chithigun23/CustomMechanicalKeyboard/KeyboardBrief.pptx

## Keyboard brief

## Keyswitch operation

- Spring returned plastic stem pushes a leaf spring which makes contact between the two pins, seen on the right.
- “Clicky” switches have a paperclip like spring to make a sound, seen on the left

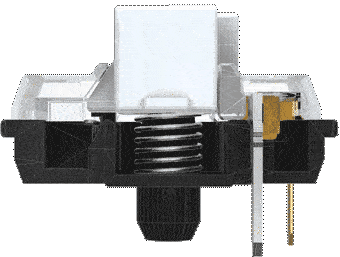
[picture p1: figure]
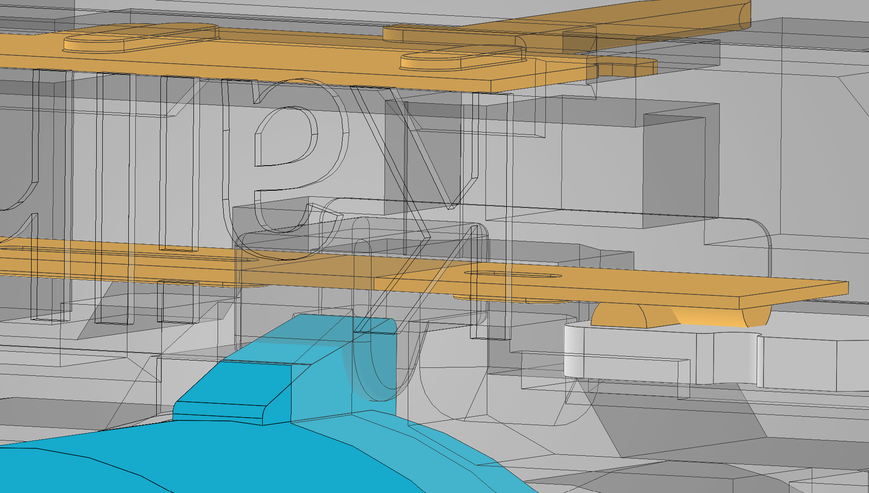
[picture p2: figure]

## Key matrix

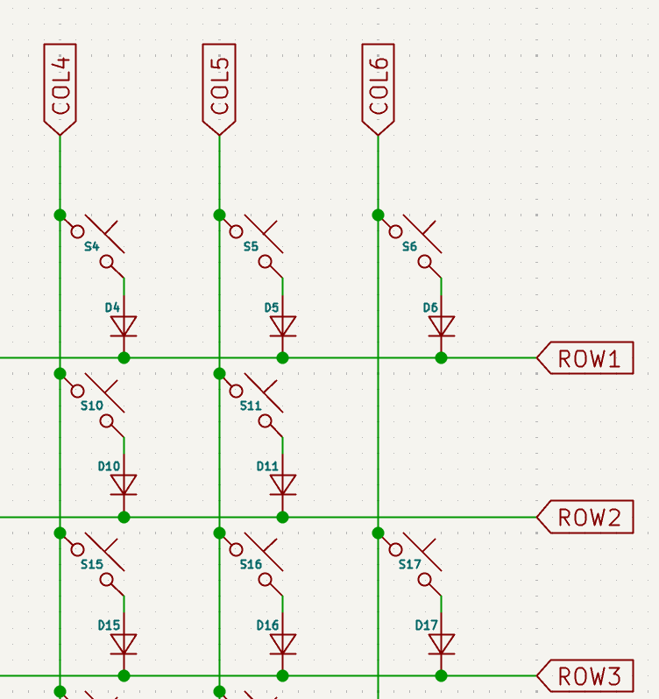
[picture p3: figure]

- Key presses utilise a matrix, like LED arrays, to reduce the GPIO pins required.
- One dimension is scanned using MCU output and another receives using MCU input.
- Diodes are used to stop ghosting, like how LED arrays ghost
- Two min video if you want (https://www.youtube.com/shorts/H4HbXRA4AxI)

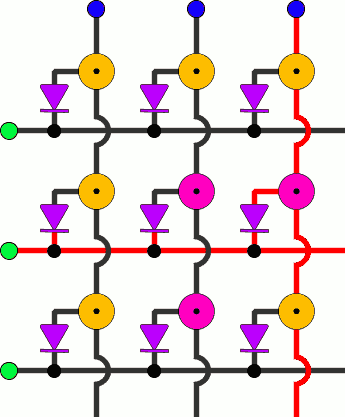
[picture p4: figure]
Building a Keyboard: Part II - Into The Matrix | The N00b Developer - A LinuxHermit's Journey

## Keyboard subsystems

- Multiple subsystems with interfacing considerations. In design order:
  1. MCU: STM32
  2. Keyswitch Array PCB
  3. Peripheral Board (Optional OLED display and volume encoder)
  4. Chassis and keycaps

## Interfacing

- Due to sizing requirements, the MCU is designed first, which will be made to fit onto keyboard PCB.
- Upgradeable MCU utilising a daughterboard
- Prioritise low profile design
- Idea is to have the MCU under the OLED display

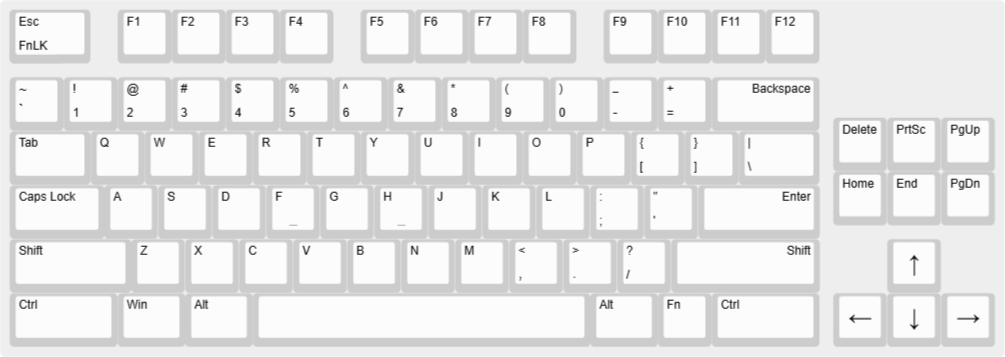
[picture p5: figure]

## Chassis

- Eventual plan for CNC Aluminium, able to create a working model using PLA or other FDM 3D printing material.
- Grounding and isolation considerations with using metal chassis
- Use of PLA sheets to electrically isolate PCB from chassis
- Star point grounding directly to MCU’s USB TVS diodes
- Mock-up on right

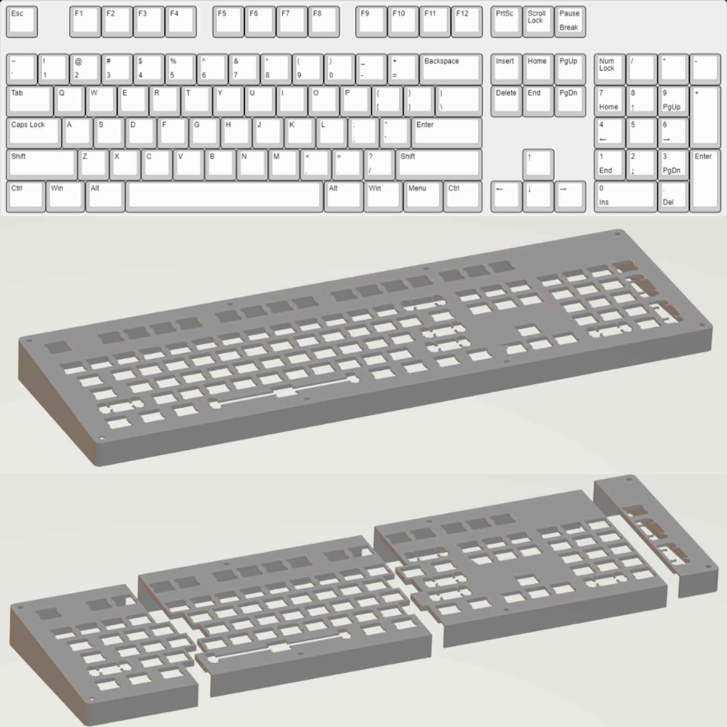
[picture p6: figure]

## Firmware

- Utilise QMK (Quantum Mechanical Keyboard) firmware
- Runs on many MCUs, preference for ARM Cortex M series
- USB consideration, some MCUs are funny with it
  - Use MCU that others have used
- Refer to QMK recommended MCU list
  - https://docs.qmk.fm/compatible_microcontrollers

## MCU

- STM32F072CBT6 (https://www.st.com/en/microcontrollers-microprocessors/stm32f072cb.html) chosen, large amount of flash and very well supported for QMK applications, more than enough GPIO, crystal-less USB 2.0.
  - Turns out a YT tutorial also chose this (https://youtu.be/o7SF2TPVV6o?si=8q0OHPD7txAeKULq)
- USB C interface, emphasis on ESD protection and signal integrity
  - Route USB as differential pairs
  - Good application specific TVS (Transient Voltage Supressing) diode chip
    - USBLC6-2 (https://www.st.com/resource/en/datasheet/usblc6-2.pdf)
- Minimised footprint

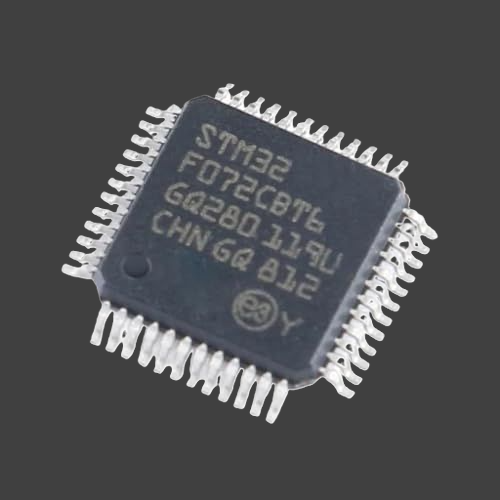
[picture p7: figure]
Stm32F072Cbt6 Stm32F072 Stm32 F072Cbt6 F072Cb Lqfp-48 Arm Cortex-M0 32-Bit Microcontroller Mcu Ic Controller Chip New for Original

## MCU So far

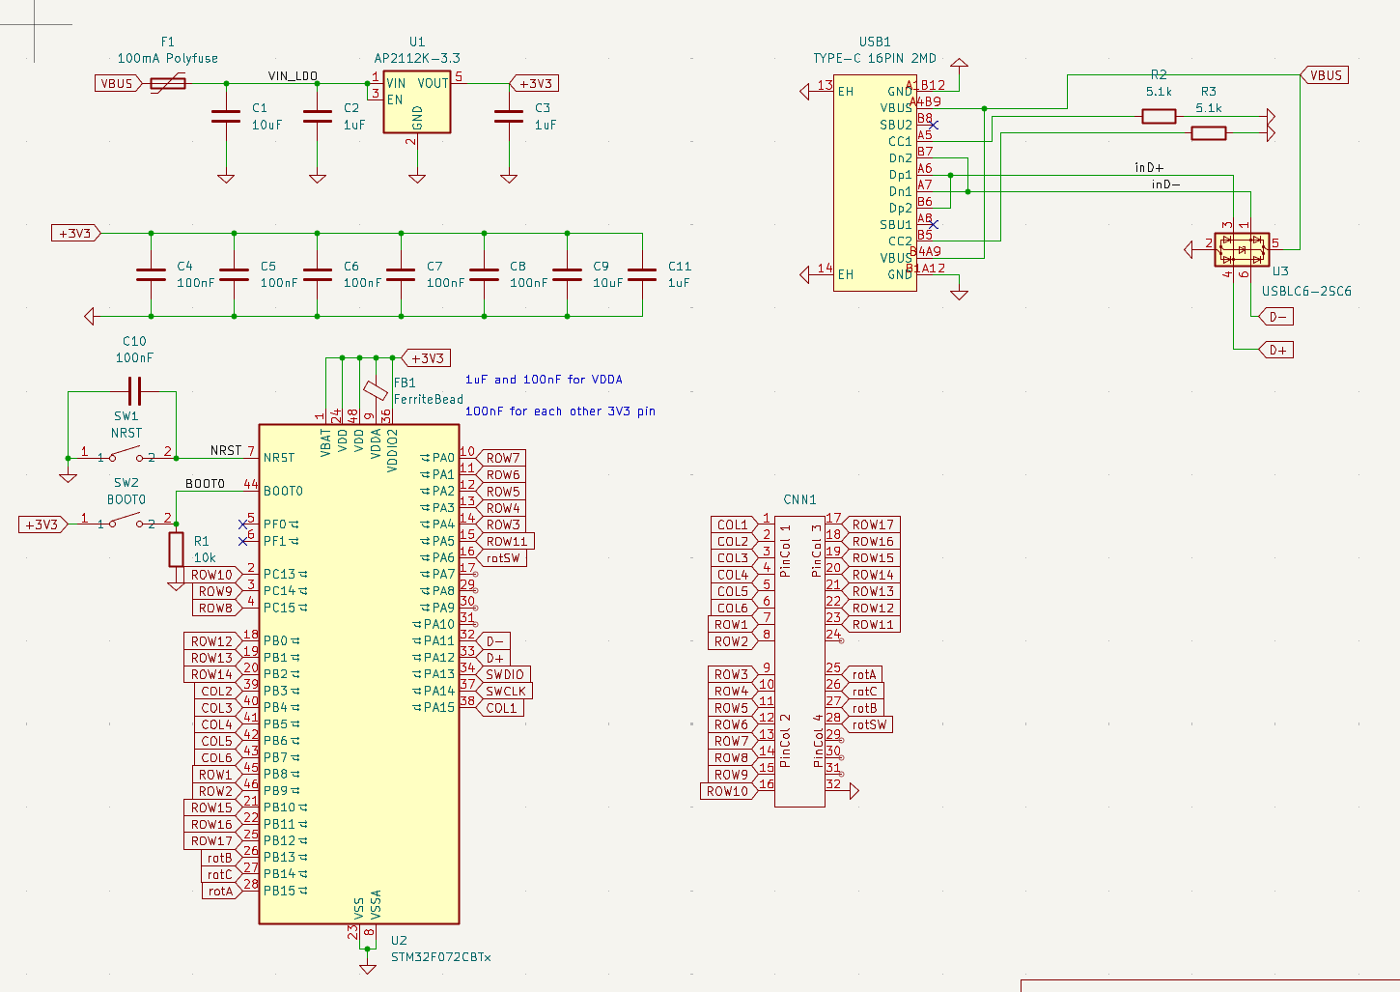
[picture p8: figure]
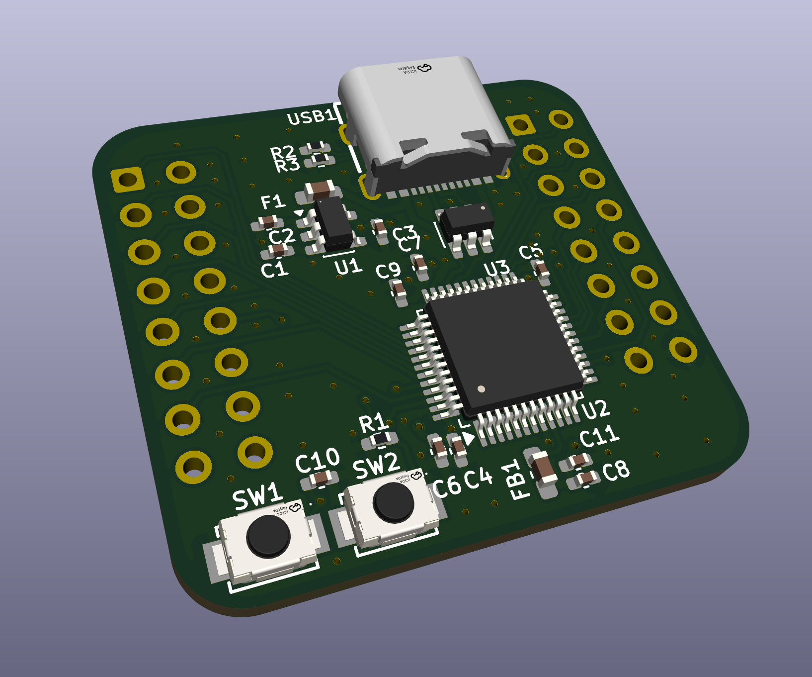
[picture p9: figure]

## Thanks
