chithigun23/CustomMechanicalKeyboard/keyMap.png

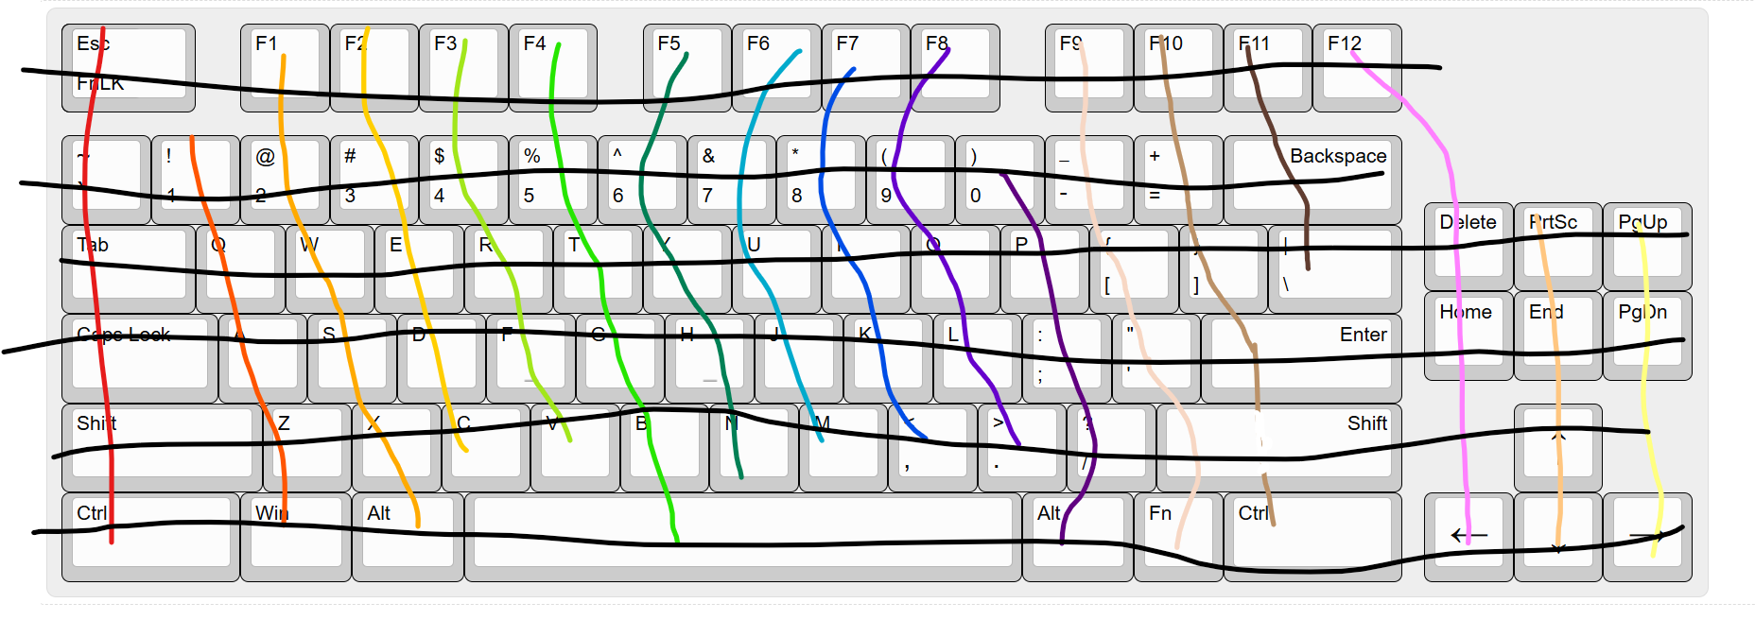
keyMap.png
