chithigun23/CustomMechanicalKeyboard/CNC Files/assembly_cnc.step

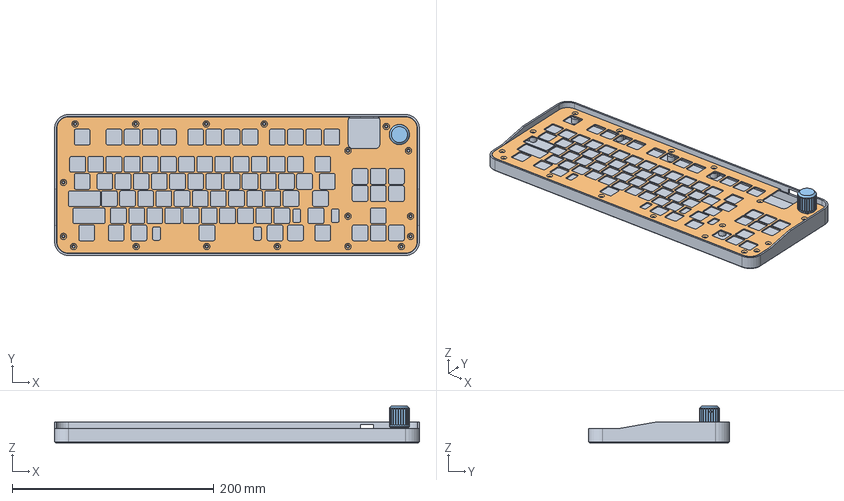
[picture p11: CAD file, 2026-09-02]
CNC Files/assembly_cnc.step
361.8 x 139.8 x 36.5 mm
