chithigun23/CustomMechanicalKeyboard/3D Print Files/keyboard_plate_flat.dxf

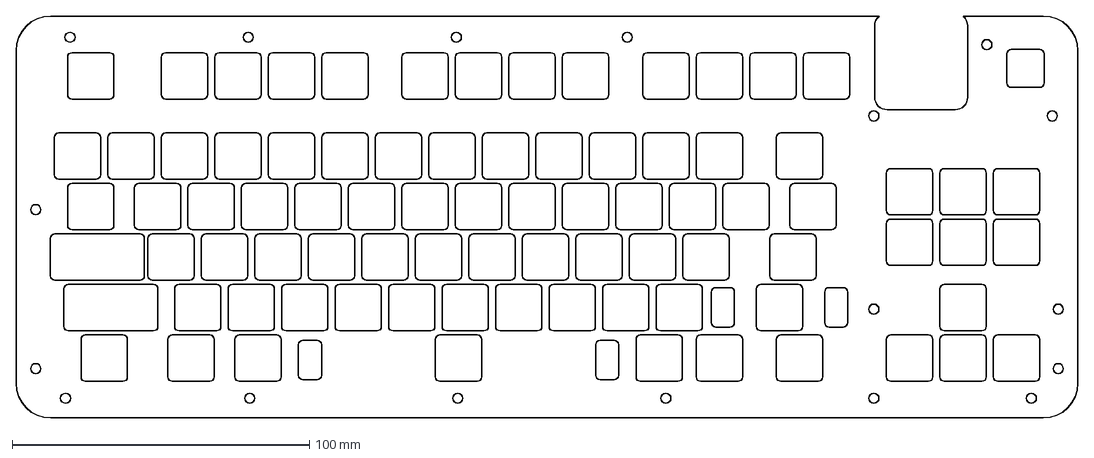
[picture p12: CAD file, 2026-09-02]
3D Print Files/keyboard_plate_flat.dxf
357.2 x 135.2 mm
