chithigun23/CustomMechanicalKeyboard/KiCAD/kbProjectLib/3d/Pins.STEP

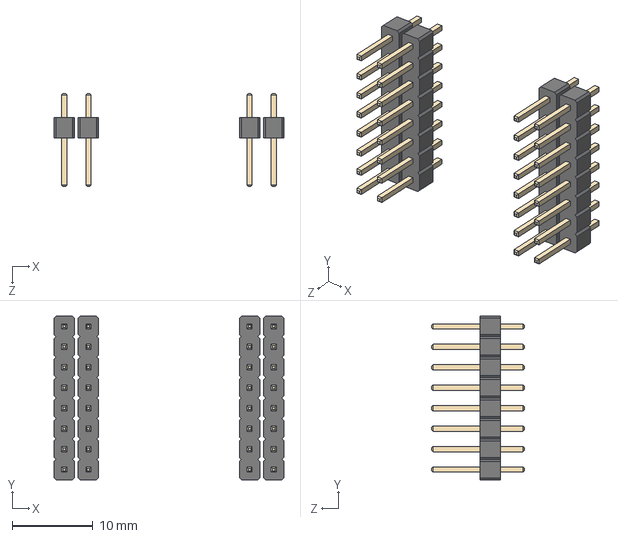
[picture p13: CAD file, 2026-08-01]
KiCAD/kbProjectLib/3d/Pins.STEP
28.5 x 20.3 x 11.5 mm
PinHeader_1x08_P2.54mm_Vertical.step x 4
