chithigun23/CustomMechanicalKeyboard/KiCAD/mcuBoard/mcu_DaughterBoard.step

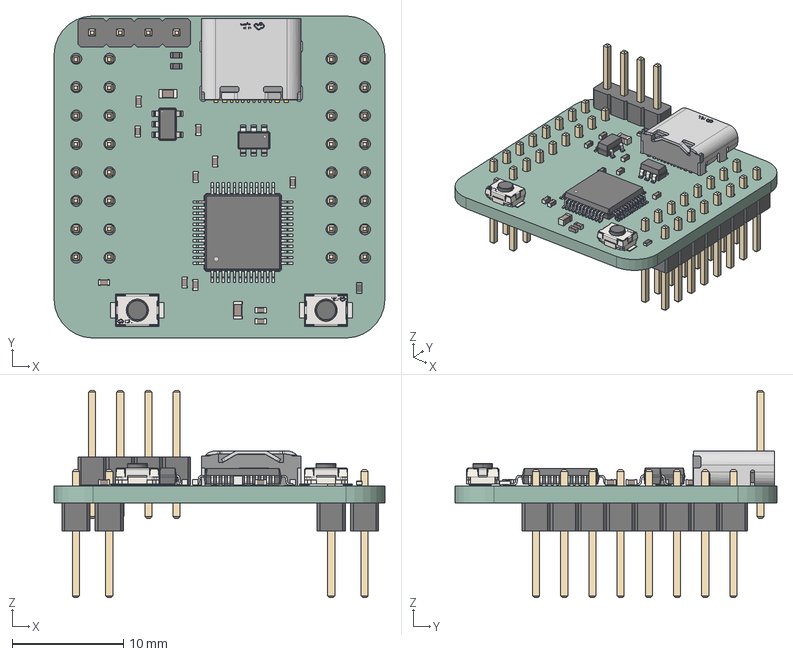
[picture p14: CAD file, 2026-09-03]
KiCAD/mcuBoard/mcu_DaughterBoard.step
29.8 x 29.0 x 18.7 mm
LQFP-48_7x7mm_P0.5mm
R_0402_1005Metric x 3
C_0603_1608Metric x 2
C_0402_1005Metric x 11
SOT-23-5
SOT-23-6
SW-SMD_L3.9-W2.9-H2.0-LS4.8 x 2
USB-C-SMD_TYPE-C-6PIN-2MD-073
PinHeader_1x04_P254mm_Vertical
PinHeader_1x08_P2.54mm_Vertical.step x 4
mcu_DaughterBoard_PCB
