chithigun23/CustomMechanicalKeyboard/stencil_front.3mf

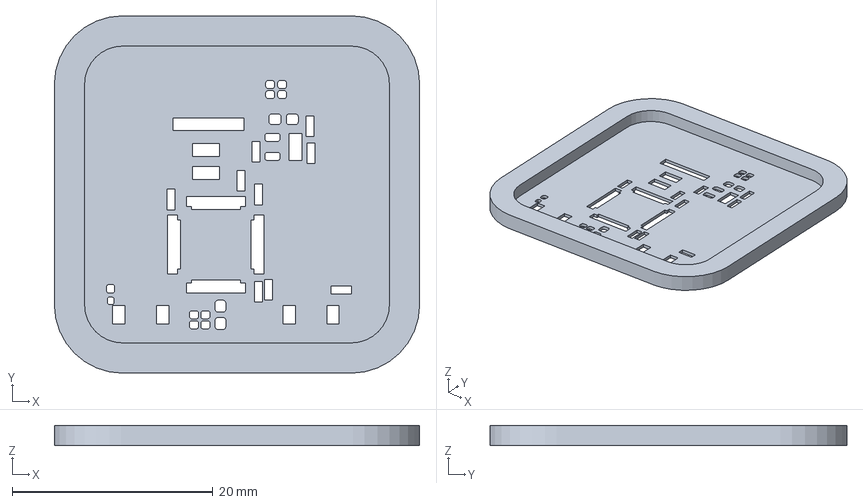
[picture p15: CAD file, 2026-08-24]
stencil_front.3mf
36.4 x 35.6 x 2.00 mm
