chithigun23/CustomMechanicalKeyboard/CNC Files/keyboard_plate.step

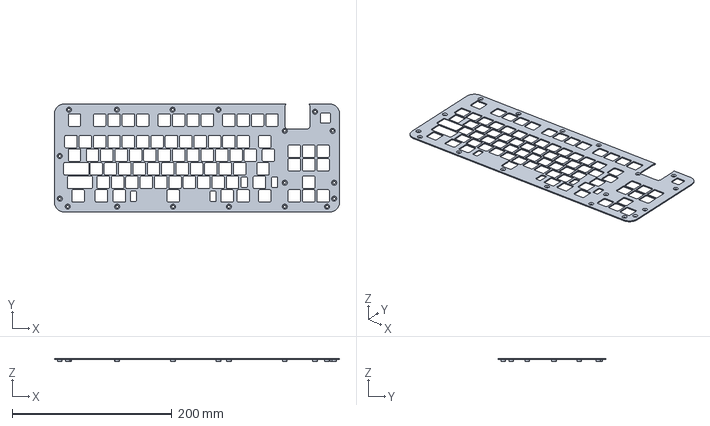
[picture p16: CAD file, 2026-09-02]
CNC Files/keyboard_plate.step
357.2 x 135.2 x 3.60 mm
