chithigun23/CustomMechanicalKeyboard/KiCAD/kbProjectLib/3d/Stabilizer_Cherry_MX_6.25u.stp

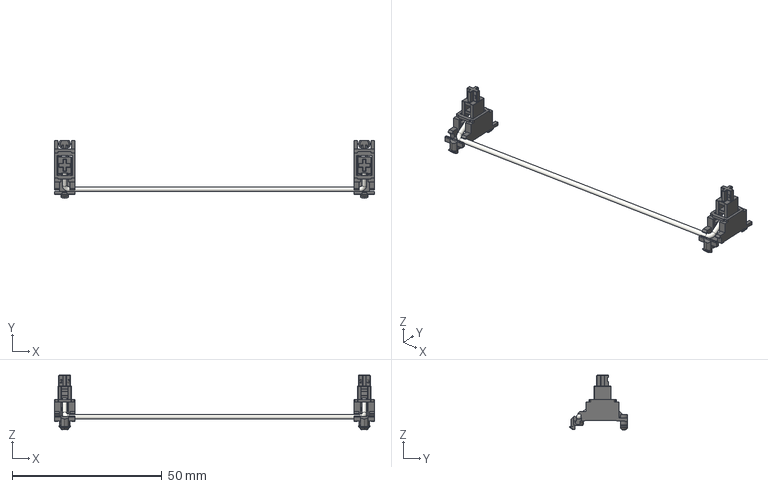
[picture p17: CAD file, 2026-08-01]
KiCAD/kbProjectLib/3d/Stabilizer_Cherry_MX_6.25u.stp
106.8 x 19.2 x 18.3 mm
