chithigun23/CustomMechanicalKeyboard/CNC Files/keyboard_case_cnc_tapped.step

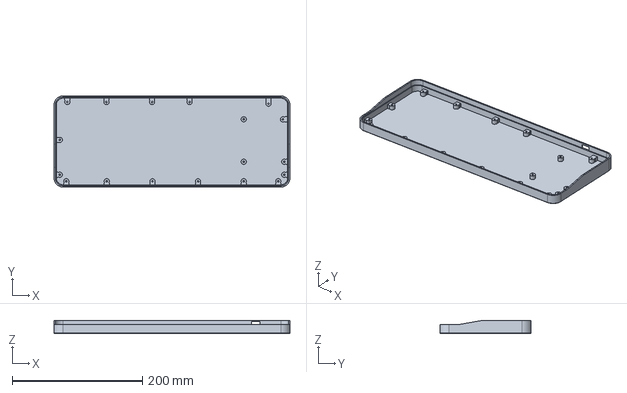
[picture p18: CAD file, 2026-09-02]
CNC Files/keyboard_case_cnc_tapped.step
361.8 x 139.8 x 20.5 mm
