chithigun23/CustomMechanicalKeyboard/KiCAD/kbProjectLib/3d/Stabilizer_Cherry_MX_2.00u.stp

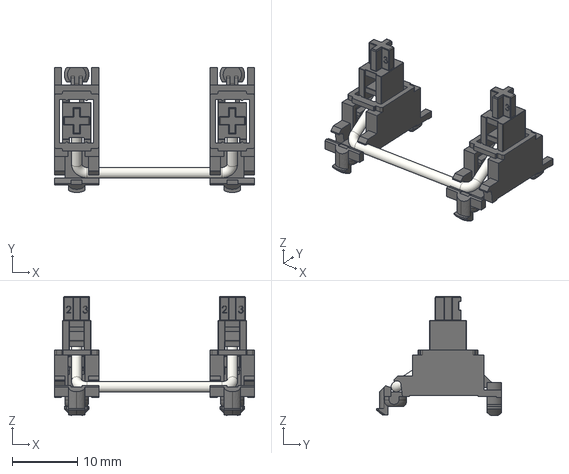
[picture p19: CAD file, 2026-08-01]
KiCAD/kbProjectLib/3d/Stabilizer_Cherry_MX_2.00u.stp
30.7 x 19.2 x 18.3 mm
