chithigun23/CustomMechanicalKeyboard/3D Print Files/encoder_knob_D_shaft.step

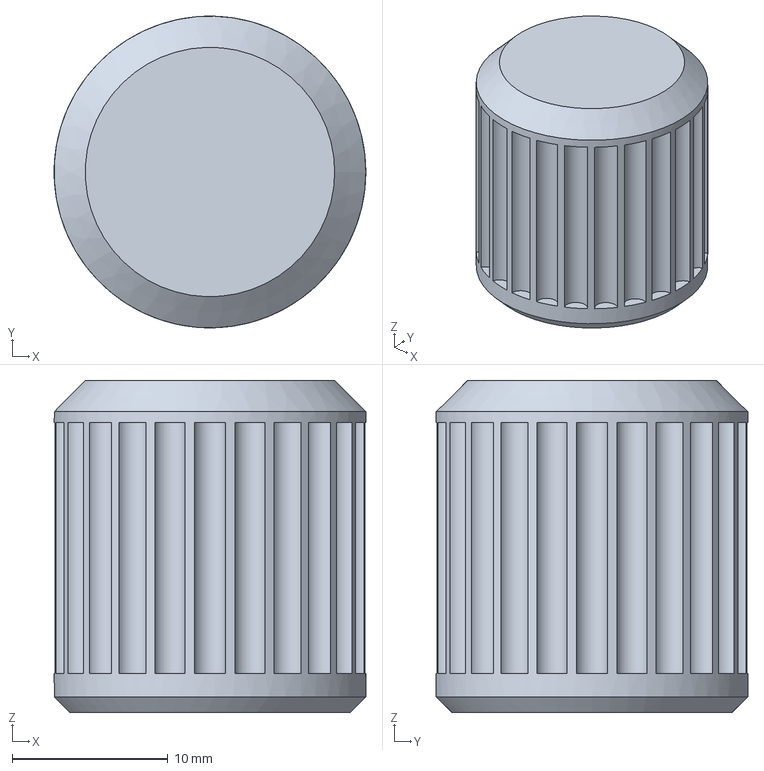
[picture p20: CAD file, 2026-09-02]
3D Print Files/encoder_knob_D_shaft.step
20.0 x 20.0 x 21.3 mm
