chithigun23/CustomMechanicalKeyboard/3D Print Files/keyboard_case.step

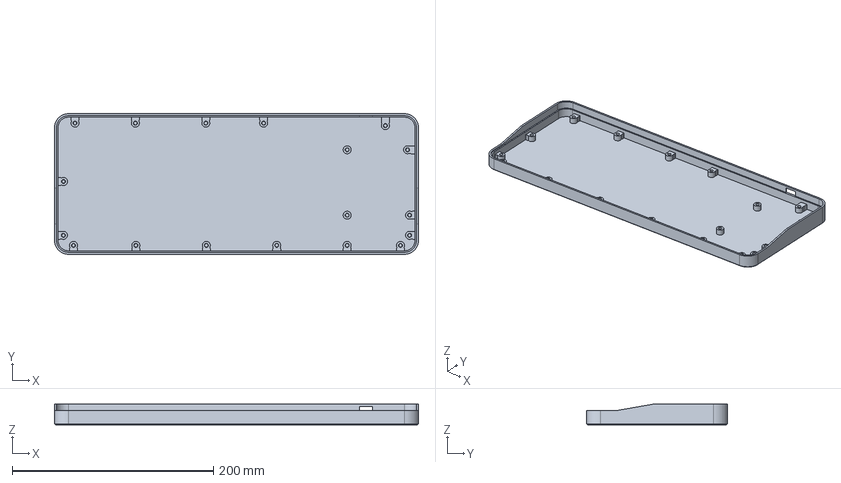
[picture p22: CAD file, 2026-09-02]
3D Print Files/keyboard_case.step
361.8 x 139.8 x 20.5 mm
