chithigun23/CustomMechanicalKeyboard/KiCAD/kbProjectLib/3d/blue.step

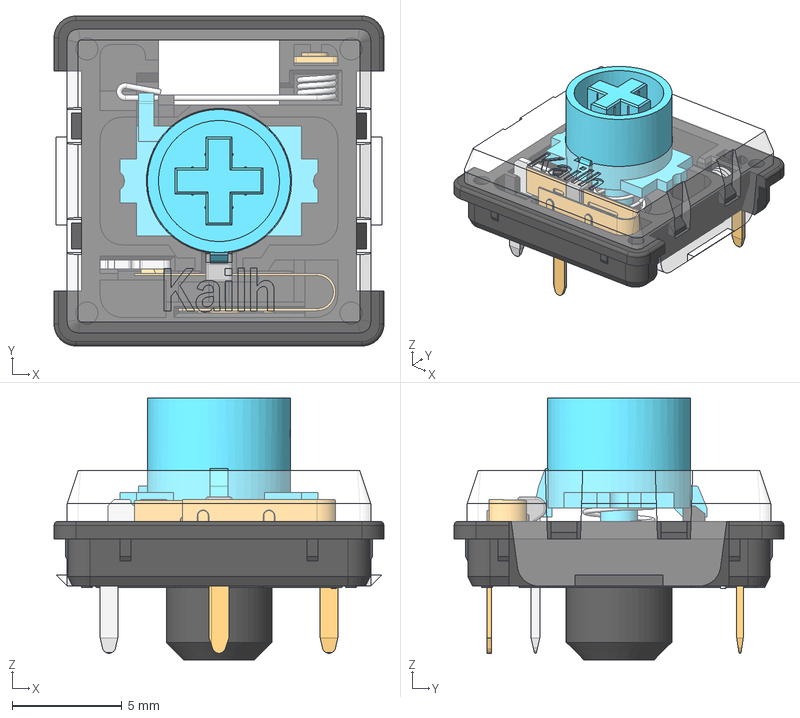
[picture p23: CAD file, 2026-07-26]
KiCAD/kbProjectLib/3d/blue.step
15.0 x 15.0 x 11.9 mm
bottom
contact
pin1
stem
top
pin2
pin3
click_bar
shrunken_spring
