chithigun23/CustomMechanicalKeyboard/CNC Files/encoder_knob_cnc_grubscrew.step

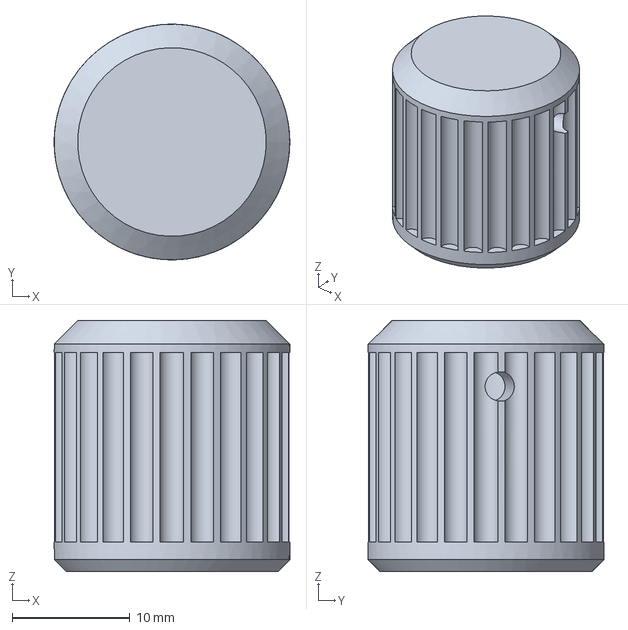
[picture p24: CAD file, 2026-09-02]
CNC Files/encoder_knob_cnc_grubscrew.step
20.0 x 20.0 x 21.3 mm
