chithigun23/CustomMechanicalKeyboard/(list of files, cad)

Other CAD files:
3D Print Files/assembly_print.step
3D Print Files/encoder_knob_D_shaft.stl
3D Print Files/keyboard_case.stl
3D Print Files/keyboard_plate.stl
stencil_front.stl
