chithigun23/CustomMechanicalKeyboard/KiCAD/keyBoard/keyboardKiCad.kicad_pcb

## KiCad design KiCAD/keyBoard/keyboardKiCad.kicad_pcb (2026-09-03)

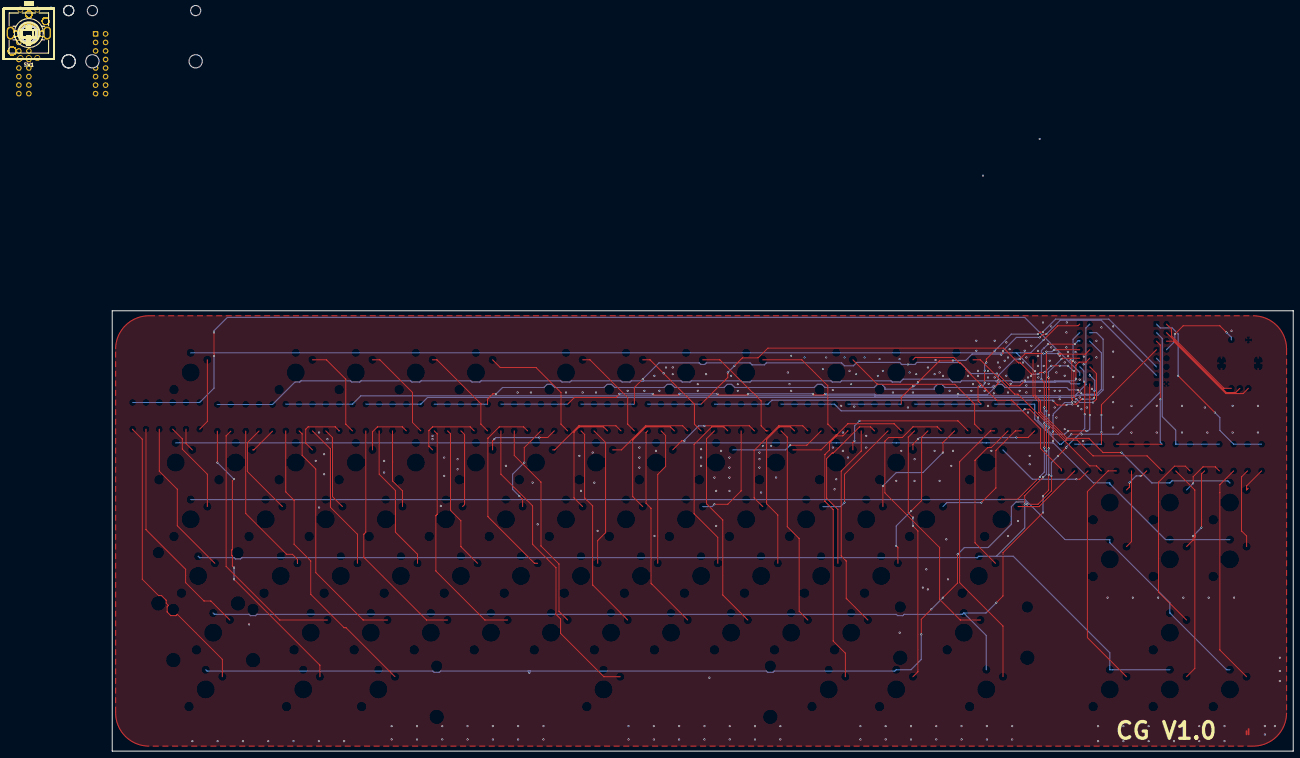
[picture p25: board keyboardKiCad.kicad_pcb from above]

Board: 2 copper layers, 354.0 x 132.0 mm, 172 parts (0 on the bottom side), 111 nets.

Parts:
CNN1: keyboardMCU_Connector
D1, D2, D3, D4, D5, D6, D7, D8, D9, D10, D11, D12, D13, D14, D15, D16, D17, D18, D19, D20, D21, D22, D23, D24, D25, D26, D27, D28, D29, D30, D31, D32, D33, D34, D35, D36, D37, D38, D39, D40, D41, D42, D43, D44, D45, D46, D47, D48, D49, D50, D51, D52, D53, D54, D55, D56, D57, D58, D59, D60, D61, D62, D63, D64, D66, D67, D68, D69, D70, D71, D72, D73, D74, D75, D76, D77, D78, D79, D80, D81, D82, D83, D84: DO-35_BD2.0-L4.0-P8.00-D0.5-FD
H1, H4: Stabilizer_Cherry_MX_2.00u
H7: Stabilizer_Cherry_MX_3.00u
H8: Stabilizer_Cherry_MX_6.25u
S1, S3, S72: SW_Kailh_Choc_V2_1.50u
S2, S7, S8, S9, S10, S12, S13, S14, S15, S16, S18, S19, S20, S21, S22, S23, S24, S25, S26, S27, S28, S29, S30, S31, S32, S34, S35, S36, S37, S38, S39, S40, S41, S42, S43, S44, S45, S46, S47, S48, S49, S50, S51, S52, S53, S54, S55, S56, S57, S59, S60, S61, S62, S64, S65, S66, S67, S70, S73, S74, S75, S76, S77, S78, S79, S80, S81, S82, S83: SW_Kailh_Choc_V2_1.00u
S4: SW_Kailh_Choc_V2_1.75u
S5, S68: SW_Kailh_Choc_V2_2.25u
S6, S69, S71: SW_Kailh_Choc_V2_2.00u
S11, S17, S58: SW_Kailh_Choc_V2_1.25u
S33: SW_Kailh_Choc_V2_6.25u
S63: SW_Kailh_Choc_V2_2.75u
SW1: RotaryEncoder_Switch_MP; SW-TH_EC11XXXXXXXX

Connections:
COL1: CNN1.7, D1.1 (K), D2.1 (K), D3.1 (K), D4.1 (K), D5.1 (K), D6.1 (K)
COL2: CNN1.8, D7.1 (K), D8.1 (K), D9.1 (K), D10.1 (K), D11.1 (K)
COL3: CNN1.9, D12.1 (K), D13.1 (K), D14.1 (K), D15.1 (K), D16.1 (K), D17.1 (K)
COL4: CNN1.10, D18.1 (K), D19.1 (K), D20.1 (K), D21.1 (K), D22.1 (K)
COL5: CNN1.11, D23.1 (K), D24.1 (K), D25.1 (K), D26.1 (K), D27.1 (K)
COL6: CNN1.12, D28.1 (K), D29.1 (K), D30.1 (K), D31.1 (K), D32.1 (K), D33.1 (K)
COL7: CNN1.13, D34.1 (K), D35.1 (K), D36.1 (K), D37.1 (K), D38.1 (K)
COL8: CNN1.14, D39.1 (K), D40.1 (K), D41.1 (K), D42.1 (K), D43.1 (K)
COL9: CNN1.15, D44.1 (K), D45.1 (K), D46.1 (K), D47.1 (K), D48.1 (K)
COL10: CNN1.16, D49.1 (K), D50.1 (K), D51.1 (K), D52.1 (K), D53.1 (K)
COL11: CNN1.23, D54.1 (K), D55.1 (K), D56.1 (K), D57.1 (K), D58.1 (K)
COL12: CNN1.22, D59.1 (K), D60.1 (K), D61.1 (K), D62.1 (K), D63.1 (K), D64.1 (K)
COL13: CNN1.21, D66.1 (K), D67.1 (K), D68.1 (K), D69.1 (K), D70.1 (K)
COL14: CNN1.20, D71.1 (K), D72.1 (K), D73.1 (K)
COL15: CNN1.19, D74.1 (K), D75.1 (K), D76.1 (K), D77.1 (K)
COL16: CNN1.18, D78.1 (K), D79.1 (K), D80.1 (K), D81.1 (K)
COL17: CNN1.17, D82.1 (K), D83.1 (K), D84.1 (K)
GND: CNN1.32, SW1.6, SW1.7, SW1.E
unnamed: D1.2 (A), S1.2
unnamed: D2.2 (A), S2.2
unnamed: D3.2 (A), S3.2
unnamed: D4.2 (A), S4.2
unnamed: D5.2 (A), S5.2
unnamed: D6.2 (A), S6.2
unnamed: D7.2 (A), S7.2
unnamed: D8.2 (A), S8.2
unnamed: D9.2 (A), S9.2
unnamed: D10.2 (A), S10.2
unnamed: D11.2 (A), S11.2
unnamed: D12.2 (A), S12.2
unnamed: D13.2 (A), S13.2
unnamed: D14.2 (A), S14.2
unnamed: D15.2 (A), S15.2
unnamed: D16.2 (A), S16.2
unnamed: D17.2 (A), S17.2
unnamed: D18.2 (A), S18.2
unnamed: D19.2 (A), S19.2
unnamed: D20.2 (A), S20.2
unnamed: D21.2 (A), S21.2
unnamed: D22.2 (A), S22.2
unnamed: D23.2 (A), S23.2
unnamed: D24.2 (A), S24.2
unnamed: D25.2 (A), S25.2
unnamed: D26.2 (A), S26.2
unnamed: D27.2 (A), S27.2
unnamed: D28.2 (A), S28.2
unnamed: D29.2 (A), S29.2
unnamed: D30.2 (A), S30.2
unnamed: D31.2 (A), S31.2
unnamed: D32.2 (A), S32.2
unnamed: D33.2 (A), S33.2
unnamed: D34.2 (A), S34.2
unnamed: D35.2 (A), S35.2
unnamed: D36.2 (A), S36.2
unnamed: D37.2 (A), S37.2
unnamed: D38.2 (A), S38.2
unnamed: D39.2 (A), S39.2
unnamed: D40.2 (A), S40.2
unnamed: D41.2 (A), S41.2
unnamed: D42.2 (A), S42.2
unnamed: D43.2 (A), S43.2
unnamed: D44.2 (A), S44.2
unnamed: D45.2 (A), S45.2
unnamed: D46.2 (A), S46.2
unnamed: D47.2 (A), S47.2
unnamed: D48.2 (A), S48.2
unnamed: D49.2 (A), S49.2
unnamed: D50.2 (A), S50.2
unnamed: D51.2 (A), S51.2
unnamed: D52.2 (A), S52.2
unnamed: D53.2 (A), S53.2
unnamed: D54.2 (A), S54.2
unnamed: D55.2 (A), S55.2
unnamed: D56.2 (A), S56.2
unnamed: D57.2 (A), S57.2
unnamed: D58.2 (A), S58.2
unnamed: D59.2 (A), S59.2
unnamed: D60.2 (A), S60.2
unnamed: D61.2 (A), S61.2
unnamed: D62.2 (A), S62.2
unnamed: D63.2 (A), S63.2
unnamed: D64.2 (A), S64.2
unnamed: D66.2 (A), S65.2
unnamed: D67.2 (A), S66.2
unnamed: D68.2 (A), S67.2
unnamed: D69.2 (A), S68.2
unnamed: D70.2 (A), S69.2
unnamed: D71.2 (A), S70.2
unnamed: D72.2 (A), S71.2
unnamed: D73.2 (A), S72.2
unnamed: D74.2 (A), S73.2
unnamed: D75.2 (A), S74.2
unnamed: D76.2 (A), S75.2
unnamed: D77.2 (A), S76.2
unnamed: D78.2 (A), S77.2
unnamed: D79.2 (A), S78.2
unnamed: D80.2 (A), S79.2
unnamed: D81.2 (A), S80.2
unnamed: D82.2 (A), S81.2
unnamed: D83.2 (A), S82.2
unnamed: D84.2 (A), S83.2
ROW1: CNN1.1, S1.1, S12.1, S18.1, S23.1, S28.1, S34.1, S39.1, S44.1, S49.1, S59.1, S65.1, S70.1, S73.1, S77.1, S81.1
ROW2: CNN1.2, S2.1, S7.1, S13.1, S19.1, S24.1, S29.1, S35.1, S40.1, S45.1, S50.1, S54.1, S60.1, S66.1, S71.1, S74.1, S78.1, S82.1
ROW3: CNN1.3, S3.1, S8.1, S14.1, S20.1, S25.1, S30.1, S36.1, S41.1, S46.1, S51.1, S55.1, S61.1, S67.1, S72.1, S75.1, S79.1, S83.1
ROW4: CNN1.4, S4.1, S9.1, S15.1, S21.1, S26.1, S31.1, S37.1, S42.1, S47.1, S52.1, S56.1, S62.1, S68.1, S76.1, S80.1
ROW5: CNN1.5, S5.1, S10.1, S16.1, S22.1, S27.1, S32.1, S38.1, S43.1, S48.1, S53.1, S57.1, S63.1, S69.1
ROW6: CNN1.6, S6.1, S11.1, S17.1, S33.1, S58.1, S64.1
rotA: CNN1.25, SW1.A
rotB: CNN1.27, SW1.B
rotC: CNN1.26, SW1.C
rotSW: CNN1.28, SW1.D
