chithigun23/CustomMechanicalKeyboard/KiCAD/mcuBoard/mcu_DaughterBoard.kicad_pcb

## KiCad design KiCAD/mcuBoard/mcu_DaughterBoard.kicad_pcb (2026-08-10)

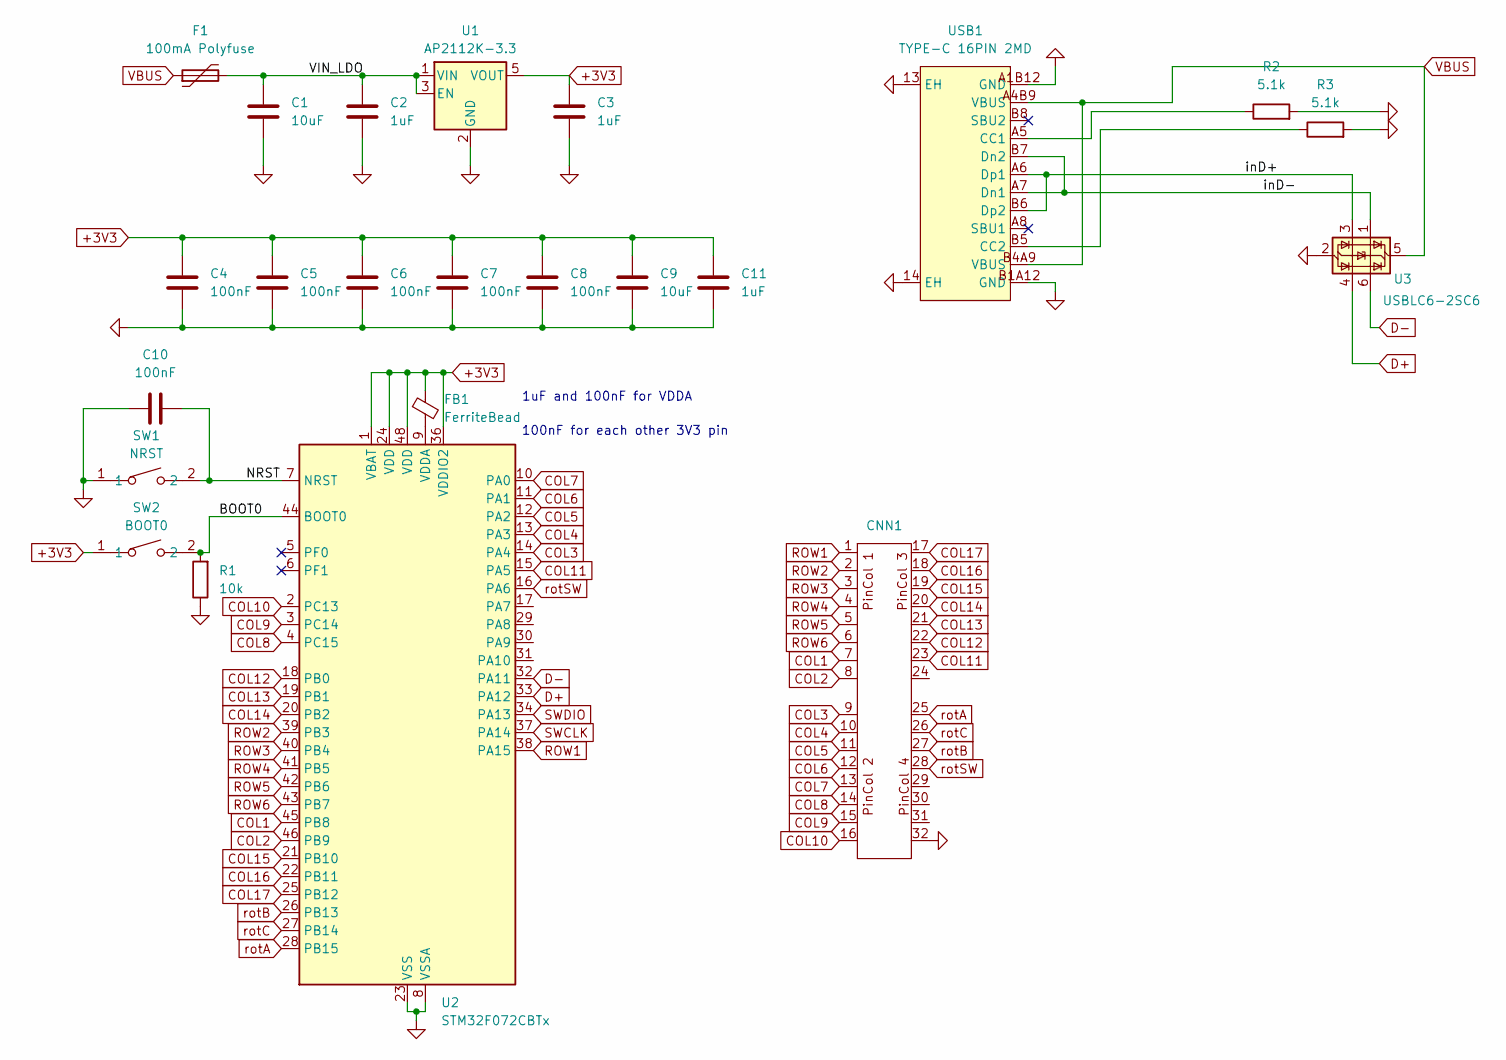
[picture p26: schematic mcu_DaughterBoard.kicad_sch]

Parts:
C1, C9: 10uF; C_0402_1005Metric_Pad0.74x0.62mm_HandSolder
C2, C3, C11: 1uF; C_0402_1005Metric_Pad0.74x0.62mm_HandSolder
C4, C5, C6, C7, C8, C10: 100nF; C_0402_1005Metric_Pad0.74x0.62mm_HandSolder
CNN1: keyboardMCU_Connector
F1: 100mA Polyfuse; C_0603_1608Metric_Pad1.08x0.95mm_HandSolder
FB1: FerriteBead; C_0603_1608Metric_Pad1.08x0.95mm_HandSolder
R1: 10k; R_0402_1005Metric_Pad0.72x0.64mm_HandSolder
R2, R3: 5.1k; R_0402_1005Metric_Pad0.72x0.64mm_HandSolder
SW1: NRST; SW-SMD_L3.9-W3.0-P4.45; MPN TS-1088-AR02016; LCSC Part C720477
SW2: BOOT0; SW-SMD_L3.9-W3.0-P4.45; MPN TS-1088-AR02016; LCSC Part C720477
U1: AP2112K-3.3; SOT-23-5
U2: STM32F072CBTx; LQFP-48_7x7mm_P0.5mm
U3: USBLC6-2SC6; SOT-23-6
USB1: TYPE-C 16PIN 2MD; USB-C-SMD_TYPE-C-16PIN-2MD-073; MPN TYPE-C 16PIN 2MD(073); LCSC Part C2765186

Connections:
+3V3: C3.1, C4.2, C5.2, C6.2, C7.2, C8.2, C9.2, C11.1, FB1.1, SW2.1, U1.5 (VOUT), U2.1 (VBAT), U2.24 (VDD), U2.36 (VDDIO2), U2.48 (VDD); also elsewhere on the board
/BOOT0: R1.2, SW2.2, U2.44 (BOOT0)
/NRST: C10.2, SW1.2, U2.7 (NRST)
/VIN_LDO: C1.2, C2.1, F1.2, U1.1 (VIN), U1.3 (EN)
/inD+: U3.3 (I/O2), USB1.A6 (Dp1), USB1.B6 (Dp2)
/inD-: U3.1 (I/O1), USB1.A7 (Dn1), USB1.B7 (Dn2)
COL1: CNN1.7, U2.45 (PB8)
COL2: CNN1.8, U2.46 (PB9)
COL3: CNN1.9, U2.14 (PA4)
COL4: CNN1.10, U2.13 (PA3)
COL5: CNN1.11, U2.12 (PA2)
COL6: CNN1.12, U2.11 (PA1)
COL7: CNN1.13, U2.10 (PA0)
COL8: CNN1.14, U2.4 (PC15)
COL9: CNN1.15, U2.3 (PC14)
COL10: CNN1.16, U2.2 (PC13)
COL11: CNN1.23, U2.15 (PA5)
COL12: CNN1.22, U2.18 (PB0)
COL13: CNN1.21, U2.19 (PB1)
COL14: CNN1.20, U2.20 (PB2)
COL15: CNN1.19, U2.21 (PB10)
COL16: CNN1.18, U2.22 (PB11)
COL17: CNN1.17, U2.25 (PB12)
D+: U2.33 (PA12), U3.4 (I/O2)
D-: U2.32 (PA11), U3.6 (I/O1)
GND: C1.1, C2.2, C3.2, C4.1, C5.1, C6.1, C7.1, C8.1, C9.1, C10.1, C11.2, CNN1.32, R1.1, R2.2, R3.2, SW1.1, U1.2 (GND), U2.8 (VSSA), U2.23 (VSS), U2.35 (VSS), U2.47 (VSS), U3.2 (GND), USB1.13 (EH), USB1.14 (EH), USB1.A1B12 (GND), USB1.B1A12 (GND); also elsewhere on the board
unnamed: FB1.2, U2.9 (VDDA)
unnamed: R2.1, USB1.A5 (CC1)
unnamed: R3.1, USB1.B5 (CC2)
ROW1: CNN1.1, U2.38 (PA15)
ROW2: CNN1.2, U2.39 (PB3)
ROW3: CNN1.3, U2.40 (PB4)
ROW4: CNN1.4, U2.41 (PB5)
ROW5: CNN1.5, U2.42 (PB6)
ROW6: CNN1.6, U2.43 (PB7)
SWCLK: U2.37 (PA14); also elsewhere on the board
SWDIO: U2.34 (PA13); also elsewhere on the board
VBUS: F1.1, U3.5 (VBUS), USB1.A4B9 (VBUS), USB1.B4A9 (VBUS)
rotA: CNN1.25, U2.28 (PB15)
rotB: CNN1.27, U2.26 (PB13)
rotC: CNN1.26, U2.27 (PB14)
rotSW: CNN1.28, U2.16 (PA6)

Notes on the sheet:
1uF and 100nF for VDDA
100nF for each other 3V3 pin

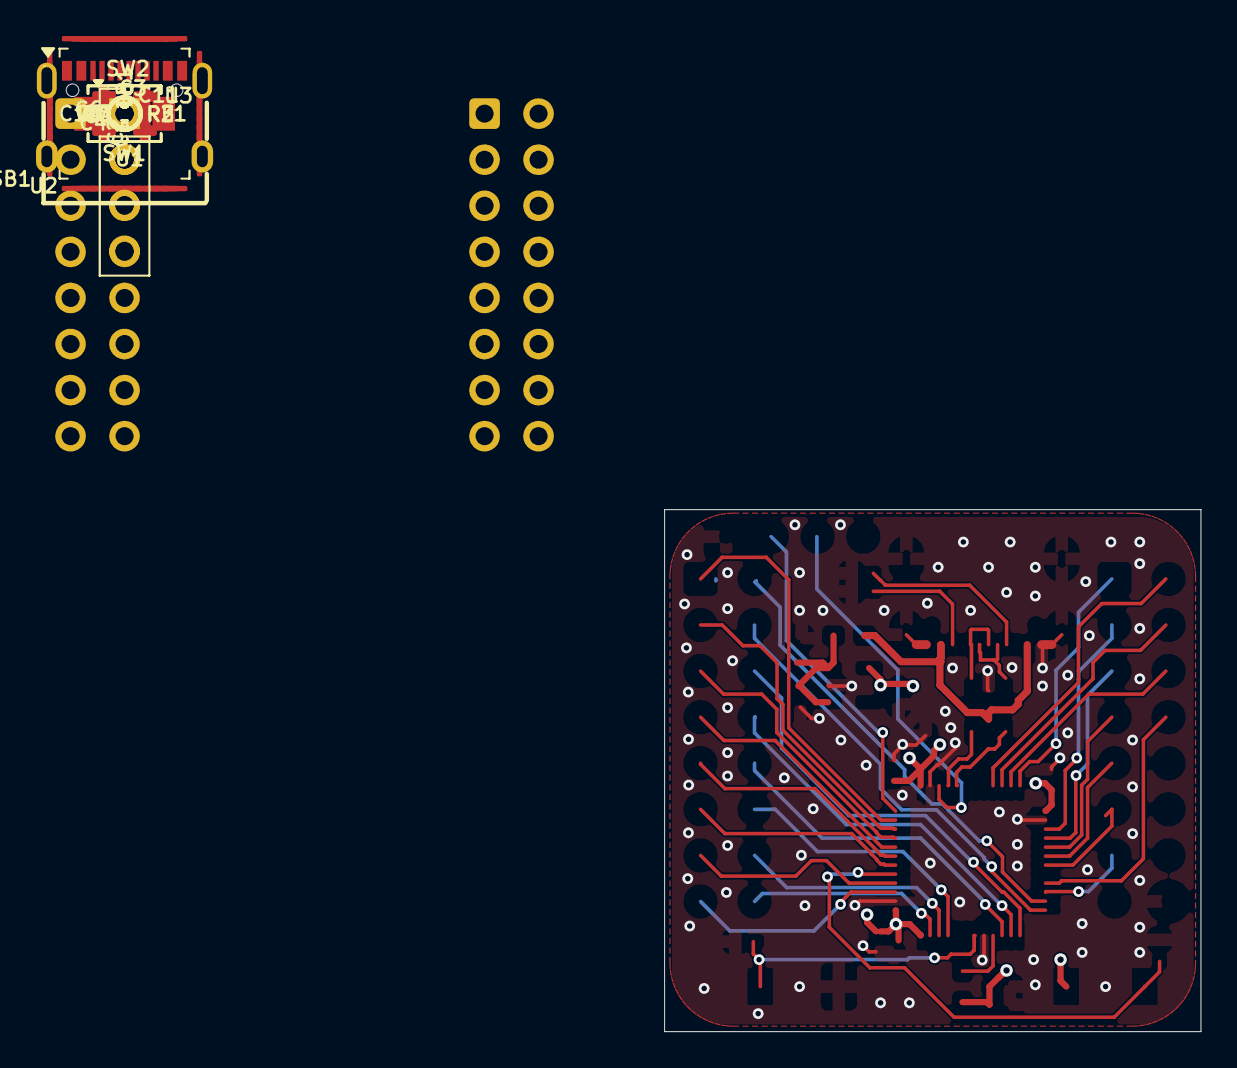
[picture p27: board mcu_DaughterBoard.kicad_pcb from above]

Board: 4 copper layers, 29.8 x 29.0 mm, 24 parts (0 on the bottom side), 42 nets.

Other parts of the board:
J1: Conn_SWD; PinHeader_1x04_P2.54mm_Vertical

Their connections:
+3V3: J1.4; also elsewhere on the board
GND: J1.1; also elsewhere on the board
SWCLK: J1.2; also elsewhere on the board
SWDIO: J1.3; also elsewhere on the board
