chithigun23/CustomMechanicalKeyboard/(commit log)

2026-07-26 Rebuild repo without invalid Windows paths, issue with Linux filepaths
    [blue.step, keyboardKiCad.kicad_pcb, keyboardKiCad.kicad_sch, mcu_DaughterBoard.kicad_pcb, mcu_DaughterBoard.kicad_sch, mcu_DaughterBoard.step]
2026-07-26 Fixed net names, columns and rows were switched.
    [mcu_DaughterBoard.kicad_pcb, mcu_DaughterBoard.kicad_sch]
2026-08-01 Fixed dimentions of the keyboard PCB, need to update 3D models
    [keyboardKiCad.kicad_pcb]
2026-08-01 Keyboard routing initially complete
    [blue.step, keyboardKiCad.kicad_pcb, keyboardKiCad.kicad_sch]
2026-08-01 saving before running 3d file fixing script
    [Stabilizer_Cherry_MX_2.00u.stp, Stabilizer_Cherry_MX_3.00u.stp, Stabilizer_Cherry_MX_6.25u.stp, keyboardKiCad.kicad_pcb, keyboardKiCad.kicad_sch]
2026-08-01 MCU board has been mounted on to the keyboard PCB. Need to check if spacing is appropriate irl using calipers. Then do mounting holes using star point grounding due to use with metal chassis. ie sepe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
    [Pins.STEP, keyboardKiCad.kicad_pcb, keyboardKiCad.kicad_sch, mcu_DaughterBoard.kicad_pcb, mcu_DaughterBoard.step]
2026-08-01 Finished routing, including chassis grounding. One thing, I might need SWD for the MCU. QMK should be able to use USB though. Need to check this.
    [keyboardKiCad.kicad_pcb, keyboardKiCad.kicad_sch]
2026-08-07 Added SWD connector headers. Touched up routing on both boards.
    [keyboardKiCad.kicad_pcb, mcu_DaughterBoard.kicad_pcb, mcu_DaughterBoard.kicad_sch]
2026-08-09 Gerber files generated, small touch ups to pass DRC. Ready for purchase.
    [keyboardKiCad.kicad_pcb, mcu_DaughterBoard.kicad_pcb]
2026-08-10 Removed star point grounding on Hector's advice.
    [keyboardKiCad.kicad_pcb]
2026-08-10 Added silly logo, regenerated gerber
    [keyboardKiCad.kicad_pcb, mcu_DaughterBoard.kicad_pcb]
2026-08-24 Added extra files
    [Pins.STEP, Stabilizer_Cherry_MX_2.00u.stp, Stabilizer_Cherry_MX_3.00u.stp, Stabilizer_Cherry_MX_6.25u.stp, blue.step, keyboardKiCad.kicad_sch, mcu_DaughterBoard.kicad_sch, mcu_DaughterBoard.step]
2026-08-24 Stencil added
    Committer: chithi <chithigun23@gmail.com>
    [stencil_front.stl]
2026-08-24 Added 3mf file
    [stencil_front.3mf]
2026-08-25 Restored kbProjectLib, schematics and fp-lib-table accidentally deleted in 995ade5
    [Pins.STEP, Stabilizer_Cherry_MX_2.00u.stp, Stabilizer_Cherry_MX_3.00u.stp, Stabilizer_Cherry_MX_6.25u.stp, blue.step, keyboardKiCad.kicad_sch, mcu_DaughterBoard.kicad_sch]
2026-09-02 Created files for CNC manufacture of case. Begun creating renders
    [assembly_cnc.step, assembly_print.step, encoder_knob_D_shaft.step, encoder_knob_D_shaft.stl, encoder_knob_cnc_grubscrew.step, keyboard_case.step, keyboard_case.stl, keyboard_case_cnc_tapped.step]
2026-09-02 Added code to render animation, intending to switch to desktop to utilise gpu
    [mcu_anim.blend, mcu_assembly.blend]
2026-09-03 Render complete
    [keyboardKiCad.kicad_pcb, mcu_DaughterBoard.step, mcu_anim.blend, mcu_assembly.blend]
